Kenji-Ishimaru/polyphony/doc/polophony_ip_core_specification.pdf

Polyphony IP Core Specification

Kenji Ishimaru | 2020

# Polyphony IP Core Specification

Kenji Ishimaru <kenji.ishimaru@ipvisers.com>

# Revision History

Rev. | Date | Author | Description
0.9 | 2020/06/30 | Kenji Ishimaru | First Release
0.91 | 2020/07/16 | Kenji Ishimaru | Terminology changed: master to initiator, slave to target

# Contents

４-３９ VTX0_X - VTX0_IW, VTX1_X - VTX1_IW, VTX2_X - VTX2_IW 29

# １Introduction

Polyphony is a real-time 3D graphics rendering IP Core. The IP Core reads 3D triangle vertices from memory, then rasterizes them to 2D pixels. Note that this IP Core does not have hardware Geometry Engine. Polyphony requires software Geometry Engine, or other hardware Geometry Engine.

### １-１Features

- RTL Design
- Design Language: Verilog
- Clock Domain: 2 clocks(main clock and video clock)
- Independent from any vendor-specific module
- Interface
- 32-bit AXI4 Target Channel (register configuration)
- 64-bit AXI4 Initiator Channel (memory access)
- 3D Graphics Rasterizer
- DMAC: buffer clear, display list fetch
- Rendering image size: 640 x 480(VGA)
- Texture: 1 unit, bi-linear filtering
- Anti-Aliasing: Quincunx
- LCD Controller
- VGA size
- On-the-fly Quincunx anti-aliasing filter

Note:
This IP Core does NOT have Hardware Geometry Engine.

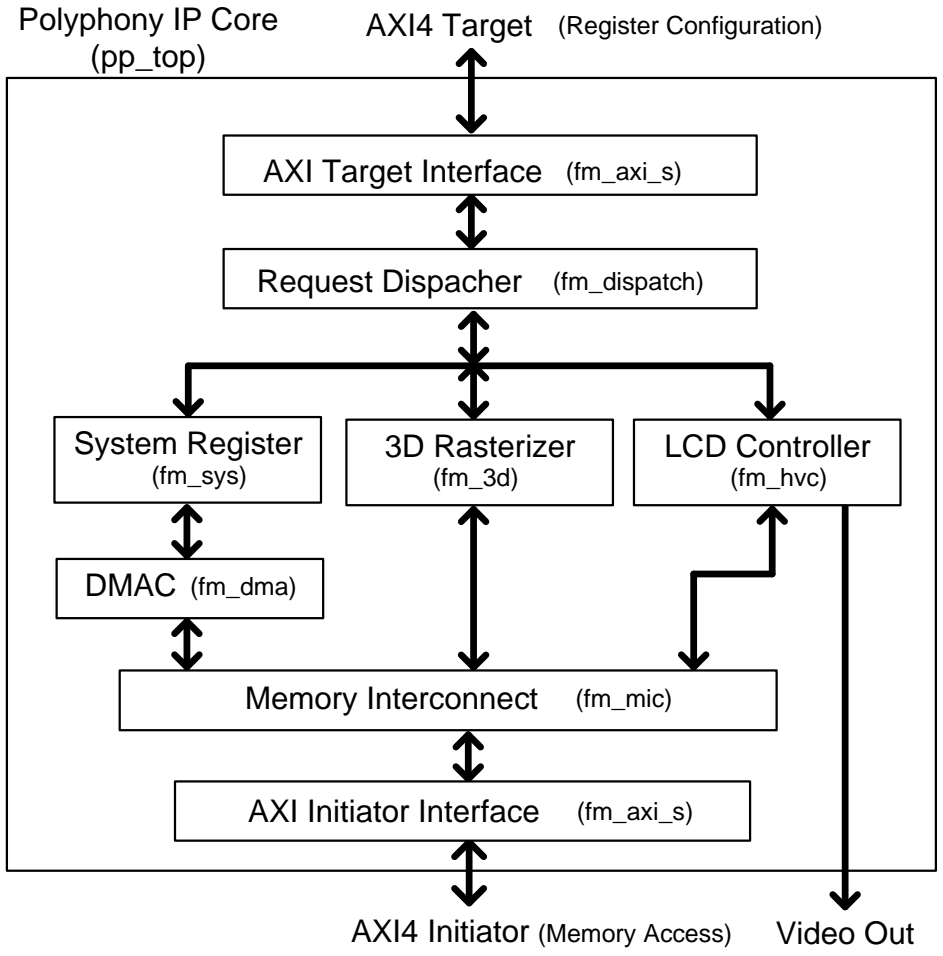
[picture p18: figure]
Polyphony IP Core (pp_top); AXI4 Target; AXI4 Initiator; (Register Configuration); (Memory Access); (fm_axi_s) (fm_dispatch) (fm_sys) DMAC (fm_dma); AXI Initiator Interface; (fm_axi_s); System Register; (fm_3d) 3D Rasterizer; (fm_hvc) LCD Controller; Video Out; Request Dispacher AXI Target Interface; Memory Interconnect; (fm_mic)

Figure 1 Interface and Internal Architecture

### １-２System Requirement

The real-time 3D graphics system would require additional system resources (Table 1, Figure 2).

Table 1 Additional system resources
Resource | Purpose
Processor | 3D scene control, IP Core control(register configuration), Geometry Engine(vertex transformation, lighting)
Memory | The storage for 3D scene object and frame buffers

3D Graphics Rendering System

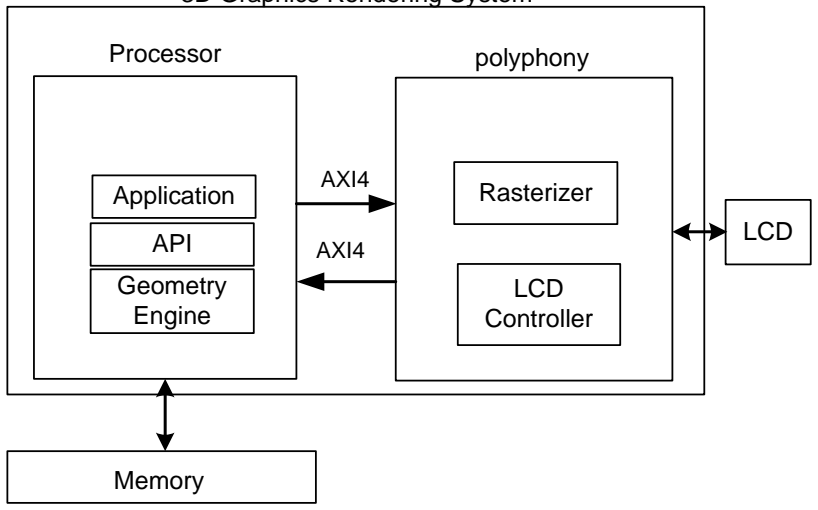
[picture p19: figure]
LCD; Memory; Processor; polyphony; LCD Controller; Rasterizer AXI4 AXI4 Application Geometry Engine; API

Figure 2 Polyphony 3D system implementation example

# ２Architecture

The IP Core contains eight sub-modules.
- AXI Target Interface
- AXI Initiator Interface
- Register Access Dispatcher
- System Register
- DMAC
- Memory Interconnect
- LCD Controller
- Rasterizer

### ２-１AXI Target Interface

AXI Target Interface converts AXI4 protocol to Polyphony internal register access protocol.

### ２-２AXI Initiator Interface

AXI Initiator Interface converts Polyphony internal memory access protocol to AXI4 protocol.

### ２-３Register Access Dispatcher

Register Access Dispatcher dispatches internal resister access from AXI Target Interface to the sub-modules depending on the destination address.

### ２-４System Register

System Register contains Polyphony system registers. Rasterizer configuration registers are stored in Rasterizer module.

### ２-５DMAC

DMAC (Direct Memory Acces Controller) fills memory by specified values.

DMAC clears frame buffer and depth buffer.

### ２-６Memory Interconnect

Polyphony has three initiator memory accesses modules internally. The modules that require initiator memory access are DMAC, Rasterizer, and LCD Controller. When multiple modules require initiator memory access simultaneously, Memory Interconnect selects one memory access from the simultaneous initiator accesses depending on the internal access priority setting.

### ２-７LCD Controller

LCD Controller reads rendered pixels from frame buffer, and then outputs those pixels at VGA pixel clock timing. LCD Controller contains on-the-fly Quincunx anti-aliasing filter.

### ２-８Rasterizer

Rasterizer fetches triangle vertices from system memory, and generates pixels from those triangles. Rasterizer contains five sub-modules (Figure 3).

Module Name | Instance Name | Description
fm_3d_cu | u_3d_cu | Rasterizer control module
fm_3d_ru | u_3d_ru | Triangle rasterizer
fm_3d_tu | u_3d_tu | Texture unit
fm_3d_pu | u_3d_pu | Pixel unit
fm_3d_mu | u_3d_mu | Memory access cache unit

Table 2 Rasterizer(fm_3d) sub-modules

Rasterizer

to/from AXI Initiator Interface | to/from AXI Initiator Interface
Rasterize u_3d_ru | Pixel Read/Write u_3d_pu Texture Unit u_3d_tu

Memory Access Cache u_3d_mu Controler/ DMA u_3d_cu

Vertex Fetch | Color Buffer/Depth Buffer Access

Register Configuraiton to/from Request Dispatcher

Figure 3 Rasterizer internal modules

# ３Operation

### ３-１Overview

From the user side view, a single 3D-object drawing (draw arrays) requires

the following steps:
1. Vertex generation (by software Geometry Engine)
2. Register setup
3. Start rendering
4. Wait for interrupt

If there are multiple 3D objects (data arrays) in a 3D scene, repeat the

drawing steps from No.1 to No.4 for the number of data arrays.

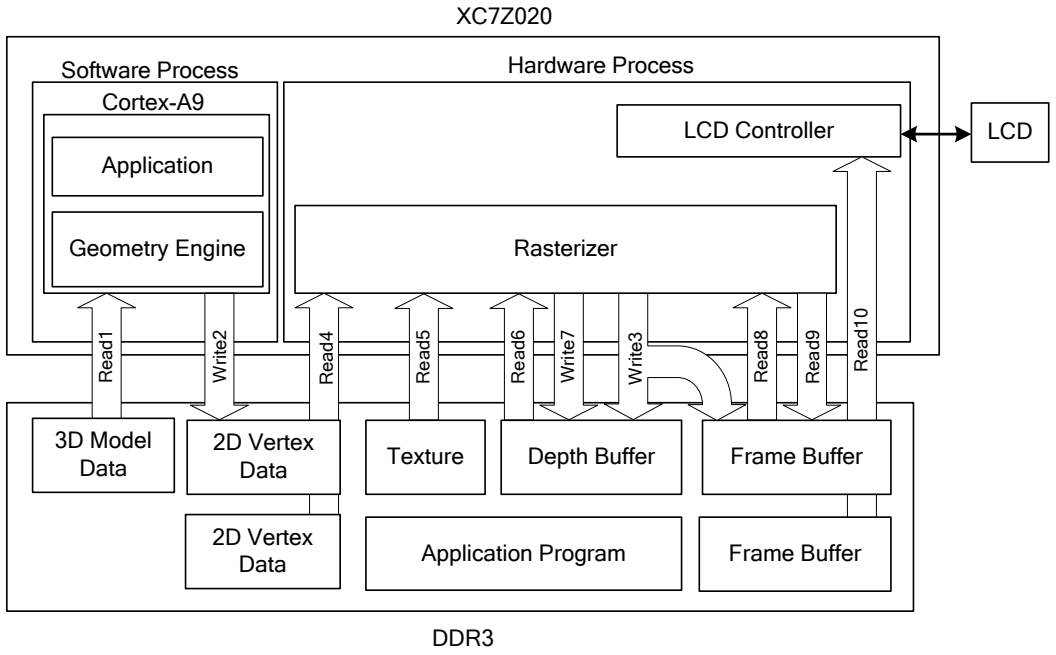
[picture p20: figure]
LCD; DDR3; Application Program; Geometry Engine; Texture; Depth Buffer; Hardware Process Cortex-A9; LCD Controller; Read1; Read5; Read10; 2D Vertex Data; Software Process; Write3; Read4; Write2; Read6; Write7 Rasterizer Read8; Read9; Application

2D Vertex Data 3D Model Data | Frame Buffer Frame Buffer

Figure 4 A single draw operations

### ３-２Vertex Generation

To render triangles for a scene frame, Polyphony requires triangle data and register-setting commands stored in the system memory. The triangle data contains 2D-projected vertex arrays generated by Geometry Engine. The data format of the vertices is IEEE single-precision floating-point number. The IP Core only supports 3-vertex format triangle array.

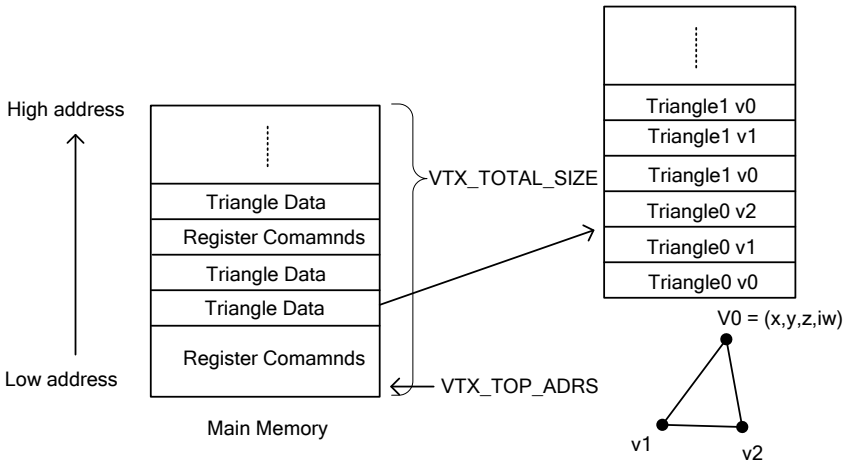
[picture p21: figure]
High address; VTX_TOTAL_SIZE; Register Comamnds

VTX_TOP_ADRS Triangle Data Triangle Data Register Comamnds Triangle Data Low address

Main Memory | Triangle0 v0 Triangle0 v1 Triangle0 v2 Triangle1 v0 Triangle1 v1 Triangle1 v0

Figure 5 Vertex and Command Array

### ３-２-１Register Commands

The register commands control subsequent triangle data processing. One Register command is 32-bit x 2 data. One 32-bit data contains address information, and the other contains write value. Upper 16-bits of the address information has a static value “7F88h”, which indicates this 32-bit data is

Register Command and subsequent 32-bit is a write value for that address. Lower 16-bits of the address information has a rasterizer register address. Lower 8-bits of the rasterizer register address is valid, and the upper 8-bit is not used.

Low address Register Write from Processor

Main Memory Register Comamnds

Address(32-bit) | Write Data(32-bit)

High address 0123_4567h 7F88h

VTX_ATTR

0000_02b4h | 1201_0000h &FFh

b4h Figure 6 Register Comamnd

### ３-２-２Triangle Data

One vertex at least has x, y, z, and iw elements (iw: inverse-w). When the

triangle has a texture attribute, each vertex of the triangle has subsequent U, V tex-coordinates. When the triangle has a primary color attribute, each vertex of the triangle has subsequent R, G, B, and Alpha channel color values.

Triangle Vertex2 Vertex1 Vertex0 Low address High address | with texture

x

y

z

iw

u

v | with primary color

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
Figure 7 Vertex Elements

### ３-３Register Setup

Before start rendering, the following register configurations are required.

Table 3 Register Setup
Category | Related Registers | Description
Frame Buffer | FB0_OFFSET FB1_OFFSET | Frame buffer address
Color Mode | COLOR_MODE | Rendering color mode
Interrupt Mask | INT_MASK | Enable rendering interrupt
Anti-Aliasing | RASTER_CTRL | Anti-Aliasing on/off
Color Buffer | COLOR_OFFSET | Color buffer address
Depth Buffer | DEPTH_OFFSET | Depth buffer address
Depth Test | DEPTH_TEST | Depth test on/off
Cache Clear | RASTER_CACHE_CTRL | Polyphony cache clear
Screen Flip | SCREEN_MODE | Screen flip on/off
Vertex Attribute | VTX_ATTR | Vertex attribute configuration
DrawArrays Top | VTX_TOP_ADRS | DrawArrays Top address

Address
DrawArrays Size | VTX_TOTAL_SIZE | DrawArrays Size
Triangle Size | NUM_OF_TRIANGLES | Number of triangles in DrawArrays

### ３-４Start Rendering

To start rendering, write 1 to VTX_DMA_CTRL [0].
After starting rendering, Polyphony reads current draw arrays from VTX_TOP_ADDS, and then writes rasterized pixels to COLOR_OFFSET.

### ３-５Interrupt Handling

When the current rendering is finished, INT_STATUS[16] is set to 1.

## ４Registers

### ４-１Overview

Table 4 Polyphony Registers

Name | Register Address (Byte Address) | Description
VIDEO_START | 0x00 | Display Controller Control
FB0_OFFSET | 0x04 | Frame Buffer0 Offset Address
FB1_OFFSET | 0x08 | Frame Buffer1 Offset Address
FB0_MS_OFFSET | 0x0C | Anti-Alias Multi Sample Buffer0 Offset
FB1_MS_OFFSET | 0x10 | Anti-Alias Multi Sample Buffer1 Offset
COLOR_MODE | 0x14 | Color Mode
AXI_MASTER_CONFIG | 0x18 | AXI Initiator Configuration
INT_STATUS | 0x20 | Interrupt Status
INT_CLEAR | 0x24 | Interrupt Clear Register
INT_MASK | 0x28 | Interrupt Mask Register
FRONT_BUFFER | 0x2C | Front/Back Buffer Status
DMA_TOP_ADRS0 | 0x30 | DMA Start Address0
DMA_TOP_ADRS1 | 0x34 | DMA Start Address1
DMA_TOP_ADRS2 | 0x38 | DMA Start Address2
DMA_TOP_ADRS3 | 0x3C | DMA Start Address3
DMA_BE_LENGTH | 0x40 | DMA Size/Be
DMA_WD0 | 0x44 | DMA Write Data0/1
DMA_WD1 | 0x48 | DMA Write Data2/3
DMA_CTRL | 0x4C | DMA Control
RASTER_CTRL | 0x200 | Raster Start
RASTER_CACHE_CTRL | 0x204 | Cache Control
VTX_TOP_ADRS | 0x208 | Vertex Buffer Top Address
VTX_TOTAL_SIZE | 0x20C | Vertex Total Transfer Size
NUM_OF_TRIANGLES | 0x210 | Number of Triangles
NUM_OF_ELEMENTS | 0x214 | Number of Elements
VTX_DMA_CTRL | 0x218 | Vertex DMA Control
TEX_OFFSET | 0x220 | Texture0 Buffer Offset

TEX_WIDTH_M1 | 0x224 | Texture0 Width-1 (floating format)
TEX_HEIGHT_M1 | 0x228 | Texture1 Height-1 (floating format)
TEX_WIDTH_UI | 0x22C | Texture1 Width (unsigned format)
TEX_CONFIG | 0x234 | Texture0 Configuration format
TEX_ENABLE | 0x258 | Texture0 Enable
TEX_BLEND_ENABLE | 0x278 | Texture0 Blend Enable
SCREEN_MODE | 0x280 | Screen Mode
COLOR_OFFSET | 0x284 | Color Buffer Offset
COLOR_MS_OFFSET | 0x288 | Multi Sample Buffer Offset
DEPTH_OFFSET | 0x28C | Depth Buffer Offset
DEPTH_MS_OFFSET | 0x290 | Depth Multi Sample Buffer Offset
BLEND_OPERATION | 0x294 | Blend Operation
DEPTH_TEST | 0x2AC | Depth Test
COLOR_MASK | 0x2B0 | Color Masking
VTX_ATTR | 0x2B4 | Attribute Configuration
VTX0_X | 0x340 | Vertex0 X
VTX0_Y | 0x344 | Vertex0 Y
VTX0_Z | 0x348 | Vertex0 Z
VTX0_IW | 0x34C | Vertex0 IW (1/W)
VTX0_P00 | 0x350 | Vertex0 Attribute0 0
VTX0_P01 | 0x354 | Vertex0 Attribute0 1
VTX0_P02 | 0x358 | Vertex0 Attribute0 2
VTX0_P03 | 0x35C | Vertex0 Attribute0 3
VTX0_P10 | 0x360 | Vertex0 Attribute1 0
VTX0_P11 | 0x364 | Vertex0 Attribute1 1
VTX0_P12 | 0x368 | Vertex0 Attribute1 2
VTX0_P13 | 0x36C | Vertex0 Attribute1 3
VTX1_X | 0x380 | Vertex1 X
VTX1_Y | 0x384 | Vertex1 Y
VTX1_Z | 0x388 | Vertex1 Z
VTX1_IW | 0x38C | Vertex1 IW (1/W)
VTX1_P00 | 0x390 | Vertex1 Attribute0 0
VTX1_P01 | 0x394 | Vertex1 Attribute0 1
VTX1_P02 | 0x398 | Vertex1 Attribute0 2
VTX1_P03 | 0x39C | Vertex1 Attribute0 3

VTX1_P10 | 0x3A0 | Vertex1 Attribute1 0
VTX1_P11 | 0x3A4 | Vertex1 Attribute1 1
VTX1_P12 | 0x3A8 | Vertex1 Attribute1 2
VTX1_P13 | 0x3AC | Vertex1 Attribute1 3
VTX2_X | 0x3C0 | Vertex2 X
VTX2_Y | 0x3C4 | Vertex2 Y
VTX2_Z | 0x3C8 | Vertex2 Z
VTX2_IW | 0x3CC | Vertex2 IW (1/W)
VTX2_P00 | 0x3D0 | Vertex2 Attribute0 0
VTX2_P01 | 0x3D4 | Vertex2 Attribute0 1
VTX2_P02 | 0x3D8 | Vertex2 Attribute0 2
VTX2_P03 | 0x3DC | Vertex2 Attribute0 3
VTX2_P10 | 0x3E0 | Vertex2 Attribute1 0
VTX2_P11 | 0x3E4 | Vertex2 Attribute1 1
VTX2_P12 | 0x3E8 | Vertex2 Attribute1 2
VTX2_P13 | 0x3EC | Vertex2 Attribute1 3

### ４-２VIDEO_START

Bits | R/W | POR | Description
31:17 | Reserved
16 | RW | 0 | Buffer Blend mode for anaglyph 0: Disable 1: Enable
15:10 | Reserved
9:8 | RW | 0 | 2’b00: Anti-Aliasing disable 2’b11: Anti-Aliasing enable
7:1 | Reserved
0 | RW | 0 | Display Controller Start 0: Stop 1: Start

### ４-３FB0_OFFSET

Bits | R/W | POR | Description
31:20 | RW | Unkown | Frame Buffer0 top address
19:0 | R | 0 | Always 0
FB0_ADDR is a 32-bit byte address value. The address specifies the top of frame buffer address. The lowest 20 bits are not configurable (fixed as 0).

### ４-４FB1_OFFSET

Bits | R/W | POR | Description
31:20 | RW | Unkown | Frame Buffer1 top address
19:0 | R | 0 | Always 0
FB1_ADDR is a 32-bit byte address value. The address specifies the top of frame buffer address. The lowest 20 bits are not configurable (fixed as 0).

### ４-５FB0_MS_OFFSET

Bits | R/W | POR | Description
31:20 | RW | Unkown | Anti-Alias Multi Sample Buffer0 top address
19:0 | R | 0 | Always 0
FB0_MS_ADDR is a 32-bit byte address value. The address specifies the top of frame buffer address. The lowest 20 bits are not configurable (fixed as 0).

### ４-６FB1_MS_OFFSET

Bits | R/W | POR | Description
31:20 | RW | Unkown | Anti-Alias Multi Sample Buffer1 top address
19:0 | R | 0 | Always 0
FB1_MS_ADDR is a 32-bit byte address value. The address specifies the top of frame buffer address. The lowest 20 bits are not configurable (fixed as 0).

### ４-７COLOR_MODE

Bits | R/W | POR | Description
31:2 | Reserved
1:0 | RW | 0 | 11 = 8:8:8:8

10 = 4:4:4:4
01 = 5:5:5:1
00 = 5:6:5

### ４-８AXI_MASTER_CONFIG

Bits | R/W | POR | Description
31:0 | Reserved

### ４-９INT_STATUS

Bits | R/W | POR | Description
31:17 | Reserved
16 | RW | 0 | Vertex transfer DMA status 1 = Finished 0 = IDLE or not finished
8 | RW | 0 | DMA status 1 = DMA is finished 0 = DMA is not finished, or IDLE
0 | RW | 0 | V-sync status. 1 = In V-sync period 0 = Not in V-sync period

### ４-１０INT_CLEAR

Bits | R/W | POR | Description
31:1 | Reserved
0 | RW | 0 | V-sync interrupt is clear when the bit is set. V-sync interrupt is also clear automatically when V-sync term is finished.

### ４-１１INT_MASK

Bits | R/W | POR | Description
31:1 | Reserved
2 | RW | 0 | Vertex transfer DMA interrupt mask 1 = Mask 0 = Enable
1 | RW | 0 | DMA interrupt mask 1 = Mask 0 = Enable
0 | RW | 0 | V-sync interrupt mask 1 = Mask 0 = Enable

### ４-１２FRONT_BUFFER

Bits | R/W | POR | Description
31:1 | Reserved
0 | RW | 0 | This specifies current frame buffer displayed on LCD 1 = Frame Buffer1 is displaying on LCD 0 = Frame Buffer0 is displaying on LCD

### ４-１３DMA_TOP_ADRS0-3

Bits | R/W | POR | Description
31:12 | RW | Unknown | DMA0 Top Address
11:0 | R | 0 | Always 0

### ４-１４DMA_BE_LENGTH

Bits | R/W | POR | Description
31:16 | Reserved
27:24 | RW | Unknown | Byte enable
23:18 | Reserved
17:0 | RW | Unknown | DMA transfer size.(32bit)

### ４-１５DMA_WD0,1

Bits | R/W | POR | Description
31:0 | RW | Unknown | DMA Write data

### ４-１６DMA_CTRL

Bits | R/W | POR | Description
31:9 | Reserved
8 | RW | 0 | DMA interrupt end flag
7:4 | RW | 00 | DMA mode Bit4 : DMA0 enable Bit5: DMA1 enable Bit6: DMA2 enable Bit7: DMA3 enable
3:1 | Reserved
0 | RW | 0 | DMA start 1 = In DMA processing 0 = Idle

### ４-１７RASTER_CTRL

Bits | R/W | POR | Description
31:19 | Reserved
18 | R | 0 | Pixel Unit Idle
17 | R | 0 | Texture Unit Idle
16 | R | 0 | Raster Unit Idle
15:9 | Reserved
8 | RW | 0 | 0: Normal rendering 1: Anti-aliasing mode
7:1 | Reserved
0 | RW | 0 | Start triangle rasterize. 1 = In processing 0 = Idle or finished

### ４-１８RASTER_CACHE_CTRL

Bits | R/W | POR | Description
31:9 | Reserved
8 | RW | 0 | Color cache flush 1 = In cache flush processing 0 = Idle or cache flush finished
7:1 | Reserved
0 | RW | 0 | Cache tag initialization. Color/Depth/Texture caches 1 = cache tag initialization

### ４-１９VTX_TOP_ADRS

Bits | R/W | POR | Description
31:16 | RW | Unkown | Vertex Buffer Top Address
15:0 | R | 0 | Always 0

### ４-２０VTX_TOTAL_SIZE

Bits | R/W | POR | Description
31:21 | Reserved
20:0 | RW | Unkown | Vertex size to be transfered

### ４-２１NUM_OF_TRIANGLES

Bits | R/W | POR | Description
31:21 | Reserved
15:0 | RW | Unkown | Number of triangles to be transferred

### ４-２２NUM_OF_ELEMENTS

Bits | R/W | POR | Description
31:5 | Reserved
4:0 | RW | Unkown | Number of elements in one vertex

### ４-２３VTX_DMA_CTRL

Bits | R/W | POR | Description
31:9 | Reserved
8 | RW | 0 | DMA interrupt end flag
7:1 | Reserved
0 | RW | 0 | DMA start 1 = In DMA processing 0 = Idle

### ４-２４TEX_OFFSET

Bits | R/W | POR | Description
31:20 | RW | Unkown | Texture Top Address
19:0 | Reserved

### ４-２５TEX_WIDTH_M1

Bits | R/W | POR | Description
31:22 | Reserved
21: 0 | RW | Unkown | Texture Width-1 (22-bit floating point format)

### ４-２６TEX_HEIGHT_M1

Bits | R/W | POR | Description
31:22 | Reserved
21: 0 | RW | Unkown | Texture Height -1(22-bit floating point format)

### ４-２７TEX_WIDTH_UI

Bits | R/W | POR | Description
31:22 | Reserved
21: 0 | RW | Unkown | Texture Height -1(unsigned integer format)

### ４-２８TEX_CONFIG

Bits | R/W | POR | Description
31:11 | Reserved
10: 8 | RW | 0 | Texture Color Mode 100 = ETC 011 = 8:8:8:8 010 = 4:4:4:4 001 = 5:5:5:1 000 = 5:6:5
7:0 | Reserved

### ４-２９TEX_ENABLE

Bits | R/W | POR | Description
31:2 | Reserved
0 | RW | 0 | Texture enable 0 = disable 1 = enable

### ４-３０TEX_BLEND_ENABLE

Bits | R/W | POR | Description
31:2 | Reserved
0 | RW | 0 | Texture and primary color blend enable 0 = disable 1 = enable

### ４-３１SCREEN_MODE

Bits | R/W | POR | Description
31:9 | Reserved
8 | RW | 0 | Buffer Offset. This is for anaglyph rendering 1=Multi-Sample Buffer (Both Color and Depth) 0=Normal Buffer
7:2 | Reserved
0 | RW | 0 | Screen Vertical Flip 1=Flip 0=Normal

### ４-３２COLOR_OFFSET

Bits | R/W | POR | Description
31:20 | RW | Unkown | Color Buffer address offset
19:0 | Reserved

### ４-３３COLOR_MS_OFFSET

Bits | R/W | POR | Description
31:20 | RW | Unkown | Color buffer (multi-sample )address offset
19:0 | Reserved

### ４-３４DEPTH_OFFSET

Bits | R/W | POR | Description
31:20 | RW | Unkown | Depth buffer address offset
19:0 | Reserved

### ４-３５DEPTH_MS_OFFSET

Bits | R/W | POR | Description
31:20 | RW | Unkown | Depth buffer (multi-sample )address offset
19:0 | Reserved

### ４-３６BLEND_OPERATION

Bits | R/W | POR | Description
31:28 | Reserved
27:24 | RW | 0 | Destination blending factor. Same as source
23:20 | Reserved
19:16 | RW | 0 | Source blending factor
| | | 14 = SRC_ALPHA_SATURATE
| | | 13 = ONE_MINUS_CONSTANT_ALPHA
| | | 12 = CONSTANT_ALPHA
| | | 11 = ONE_MINUS_CONSTANT_COLOR
| | | 10 = CONSTANT_COLOR
| | | 9 = ONE_MINUS_DST_ALPHA
| | | 8 = DST_ALPHA
| | | 7 = ONE_MINUS_SRC_ALPHA
| | | 6 = SRC_ALPHA
| | | 5 = ONE_MINUS_DST_COLOR
| | | 4 = DST_COLOR
| | | 3 = ONE_MINUS_SRC_COLOR
| | | 2 = SRC_COLOR
| | | 1 = ONE
| | | 0 = ZERO
15:9 | Reserved
10:8 | RW | 0 | Blend Equation 5 = ADD_SCREEN 4 = MAX 3 = MIN 2 = REV_SUB 1 = SUB 0 = ADD
7:1 | Reserved
0 | RW | 0 | Color Blend enable 1 = enable 0 = disable

### ４-３７DEPTH_TEST

Bits | R/W | POR | Description
31:28 | Reserved
31:19 | Reserved
18:16 | RW | 0 | Depth function 7 = ALWAYS 6 = GEQUAL 5= NOTEQUAL 4 = GREATER 3 = LEQUAL 2 = EQUAL 1 = LESS 0 = NEVER
15:9 | Reserved
8 | RW | 0 | Depth mask 1 = read and write buffer 0 = read-only buffer
7:1 | Reserved
0 | RW | 0 | Depth test enable 1 = enable 0 = disable

### ４-３８VTX_ATTR

Bits | R/W | POR | Description
31:30 | Reserved
29:28 | RW | 0 | Attribute1 size 00 = 1 element 01 = 2 elements(U,V) 10 = 3 elements 11 = 4 elements(R,G,B,A)
27:26 | Reserved
25:24 | RW | 0 | Attribute1 kind 00 = Primary Color 10 = Texture0
23:17 | Reserved
16 | RW | 0 | Attribute1 enable 1 = enable 0 = disable
15:14 | Reserved
13:12 | RW | 0 | Attribute0 size 00 = no element 01 = 1 element 10 = 2 elements(U/V) 11 = 3 elements(R,G,B)
11:10 | Reserved
9:8 | RW | 0 | Attribute0 kind 00 = Primary Color 10 = Texture0
7:1 | Reserved
0 | RW | 0 | Attribute0 enable 1 = enable 0 = disable

### ４-３９VTX0_X - VTX0_IW, VTX1_X - VTX1_IW, VTX2_X - VTX2_IW

These registers store vertex coordinates of a triangle.
Bits | R/W | POR | Description
31:0 | RW | Unkown | x,y,z, and iw(inverse-w) values of the vertex. IEEE 754 single-precision binary floating point format

### ４-４０VTX_P00 - VTX_13

These registers store parametes associated with the vertex.
Bits | R/W | POR | Description
31:0 | RW | Unkown | Primatry Color: R,G,B, and Alpha color value Texture: U, V coordinats IEEE 754 single-precision binary floating point format

# ５IO Ports

### ５-１Clock&Reset

Name | Bits | Direction | Description
clk_core | 1 | In | Main clock
clk_v | 1 | In | Video clock
rst_x | 1 | In | Async reset

### ５-２Interrupt

Name | Bits | Direction | Description
o_int | 1 | Out | Interrupt Out, level

### ５-３AXI4 Target

### ５-３-１Write Address Channel

Name | Bits | Direction | Description
i_awvalid_s | 1 | In | Valid write address channel transfer indicator
i_awaddr_s[31:0] | 32 | In | The address of the first transfer in a write transaction
i_awburst_s[1:0] | 2 | In | Address changes between each transfer in a write transaction
i_awcache_s[3:0] | 4 | In | Write transaction progress through a system
i_awid_s[3:0] | 4 | In | Identification tag for a read transaction
i_awlen_s[3:0] | 4 | In | The exact number of data transfers in a write transaction
i_awlock_s[1:0] | 2 | In | The atomic characteristics of a write transaction
i_awprot_s[2:0] | 3 | In | Protection attributes of a write transaction
i_awsize_s[2:0] | 3 | In | The number of bytes in each data transfer in a write transaction
o_awready_s | 1 | Out | Write address channel transfer acceptance

### ５-３-２Write Data Channel

Name | Bits | Direction | Description
i_wvalid_s | 1 | In | Valid write data indicator
i_wstrb_s[3:0] | 4 | In | Write data strobe
i_wid_s[3:0] | 4 | In | Identification tag for write data

i_wdata_s[31:0] | 32 | In | Write data
i_wlast_s | 1 | In | Last write data transfer indicator
o_wready_s | 1 | Out | Write data acceptance

### ５-４Write Response Channel

Name | Bits | Direction | Description
o_bvalid_s | 1 | Out | Valid write response channel transfer indicator
o_bid_s[3:0] | 4 | Out | Identification tag for a write response
o_bresp_s[1:0] | 2 | Out | The status of a write transaction
i_bready_s | 1 | In | Write response acceptance

### ５-４-１Read Address Channel

Name | Bits | Direction | Description
i_arvalid_s | 1 | In | Valid Write data acceptance indicator
i_araddr_s[31:0] | 32 | In | The address of the first transfer in a read transaction
i_arburst_s[1:0] | 2 | In | Address changes between each transfer in a read transaction
i_arcache_s[3:0] | 4 | In | Read transaction progress through a system
i_arid_s[3:0] | 4 | In | Identification tag for a read transaction
i_arlen_s[3:0] | 4 | In | The exact number of data transfers in a read transaction
i_arlock_s[1:0] | 2 | In | The atomic characteristics of a read transaction
i_arprot_s[2:0] | 3 | In | Protection attributes of a read transaction
i_arsize_s[2:0] | 3 | In | The number of bytes in each data transfer in a read transaction
o_arready_s | 1 | Out | Read data acceptance acceptance

### ５-４-２Read Data Channel

Name | Bits | Direction | Description
o_rvalid_s | 1 | Out | Valid read channel transfer indicator
o_rid_s[3:0] | 4 | Out | Identification tag for read data and response
o_rdata_s[31:0] | 32 | Out | Read data

o_rlast_s | 1 | Out | Last read data indicator
i_rready_s | 1 | In | Read data acceptance

### ５-５AXI4 Initiator

### ５-５-１Write Channel

Name | Bits | Direction | Description
o_awvalid_m | 1 | Out | Valid write address channel transfer indicator
o_awaddr_m[31:0] | 32 | Out | The address of the first transfer in a write transaction
o_awburst_m[1:0] | 2 | Out | Address changes between each transfer in a write transaction
o_awcache_m[3:0] | 4 | Out | Write transaction progress through a system
o_awid_m[3:0] | 4 | Out | Identification tag for a write transaction
o_awlen_m[4:0] | 5 | Out | The exact number of data transfers in a write transaction
o_awlock_m[1:0] | 2 | Out | The atomic characteristics of a write transaction
o_awprot_m[2:0] | 3 | Out | Protection attributes of a write transaction
o_awsize_m[2:0] | 3 | Out | The number of bytes in each data transfer in a write transaction
o_awuser_m[4:0] | 5 | Out | User-defined extension for the write address channel
i_awready_m | 1 | In | Read address channel transfer acceptance

### ５-５-２Write Data Channel

Name | Bits | Direction | Description
o_wvalid_m | 1 | Out | Valid write channel transfer indicator
o_wstrb_m[7:0] | 8 | Out | Wrie data strobe
o_wid_m[3:0] | 4 | Out | Identification tag for write data
o_wdata_m[63:0] | 64 | Out | Write data
o_wlast_m | 1 | Out | Last data indicator
i_wready_m | 1 | In | Write data acceptance

### ５-５-３Write Response Channel

Name | Bits | Direction | Description
i_bvalid_m | 1 | In | Valid write response channel transfer indicator
i_bid_m[3:0] | 4 | In | Identification tag for a write response
i_bresp_m[1:0] | 2 | In | The status of a write transaction
o_bready_m | 1 | Out | Write response acceptance

### ５-５-４Read Address Channel

Name | Bits | Direction | Description
o_arvalid_m | 1 | Out | Valid read address channel transfer indicator
o_araddr_m[31:0] | 32 | Out | The address of the first transfer in a read transaction
o_arburst_m[1:0] | 2 | Out | Address changes between each transfer in a read transaction
o_arcache_m[3:0] | 4 | Out | Read transaction progress through a system
o_arid_m[3:0] | 4 | Out | Identification tag for a read transaction
o_arlen_m[4:0] | 5 | Out | The exact number of data transfers in a read transaction
o_arlock_m[1:0] | 2 | Out | The atomic characteristics of a read transaction
o_arprot_m[2:0] | 3 | Out | Protection attributes of a read transaction
o_arsize_m[2:0] | 3 | Out | The number of bytes in each data transfer in a read transaction
o_aruser_m[4:0] | 5 | Out | User-defined extension for the read address channel
i_arready_m | 1 | In | Read address channel transfer acceptance

### ５-５-５Read Data Channel

Name | Bits | Direction | Description
i_rvalid_m | 1 | In | Valid read channel transfer indicator
i_rid_m[3:0] | 4 | In | Identification tag for read data and response
i_rdata_m[63:0] | 64 | In | Read data
i_rlast_m | 1 | In | Last read data indicator
o_rready_m | 1 | Out | Read data acceptance

### ５-６Video

Name | Bits | Direction | Description
o_hsync_x | 1 | Out | H-sync
o_vsync_x | 1 | Out | V-sync
o_vr[7:0] | 8 | Out | Red color
o_vg[7:0] | 8 | Out | Green color
o_vb[7:0] | 8 | Out | Blue color

# ６Internal Floating Point Format

Rasterizer uses 22-bit floating-point format number internally. The format has 1-bit sign, 7-bit exponent, and 16-bit mantissa. Note that 16-bit mantissa contains explicit one integer bit. It is not the same as IEEE floating format, their format does not have an implicit integer bit. The explicit integer bit reduces fraction resolution, but it has several advantages, when the intermediate successive floating point calculation in hardware.

s | e | m
21 20 | 16 15 | 0

Figure 8 22-bit floating-point format
Value = −1

s × m × 2

e−15

Bias = 15(Fh)
m = 1.15(1bit integer, 15bit fraction part)

Table 5 22-bit floating-point value example
s | e | m | Value
0 | 0x0f | 0x8000 | 1.0
0 | 0x1f | 0xffff | 131071.0（positive max. number）
0 | 0x0e | 0x8000 | 0.5
0 | 0x0e | 0xc000 | 0.75
0 | 0x0d | 0x8000 | 0.25
0 | 0x02 | 0x8000 | 0.000122
0 | 0x01 | 0x8000 | 0.000061
0 | 0x00 | 0x8000 | 0.000031(denormal)
0 | 0x00 | 0x0000 | 0
1 | 0xf | 0x8000 | -1.0
1 | 0x1f | 0xffff | -131071.0.0
1 | 0xe | 0x800 | -0.5
1 | 0xe | 0x800 | -0.75
1 | 0x1 | 0x800 | -0.000061
1 | 0x0 | 0x800 | -0.000031(denormal)

Table 6 Biased exponent and actual exponent
Biased e | Actual exponent | Biased e | Actual exponent
0x1f | 2¹⁶ | 0x0f | 2⁰
0x1e | 2¹⁵ | 0x0e | 2⁻¹
0x1d | 2¹⁴ | 0x0d | 2⁻²
0x1c | 2¹³ | 0x0c | 2⁻³
0x1b | 2¹² | 0x0b | 2⁻⁴
0x1a | 2¹¹ | 0x0a | 2⁻⁵
0x19 | 2¹⁰ | 0x09 | 2⁻⁶
0x18 | 2⁹ | 0x08 | 2⁻⁷
0x17 | 2⁸ | 0x07 | 2⁻⁸
0x16 | 2⁷ | 0x06 | 2⁻⁹
0x15 | 2⁶ | 0x05 | 2⁻¹⁰
0x14 | 2⁵ | 0x04 | 2⁻¹¹
0x13 | 2⁴ | 0x03 | 2⁻¹²
0x12 | 2³ | 0x02 | 2⁻¹³
0x11 | 2² | 0x01 | 2⁻¹⁴
0x10 | 2¹ | 0x00 | Denormal Number
